ophelie43/RobotRehab2D/CAD/Assemblage RobotRehab Final.SLDASM

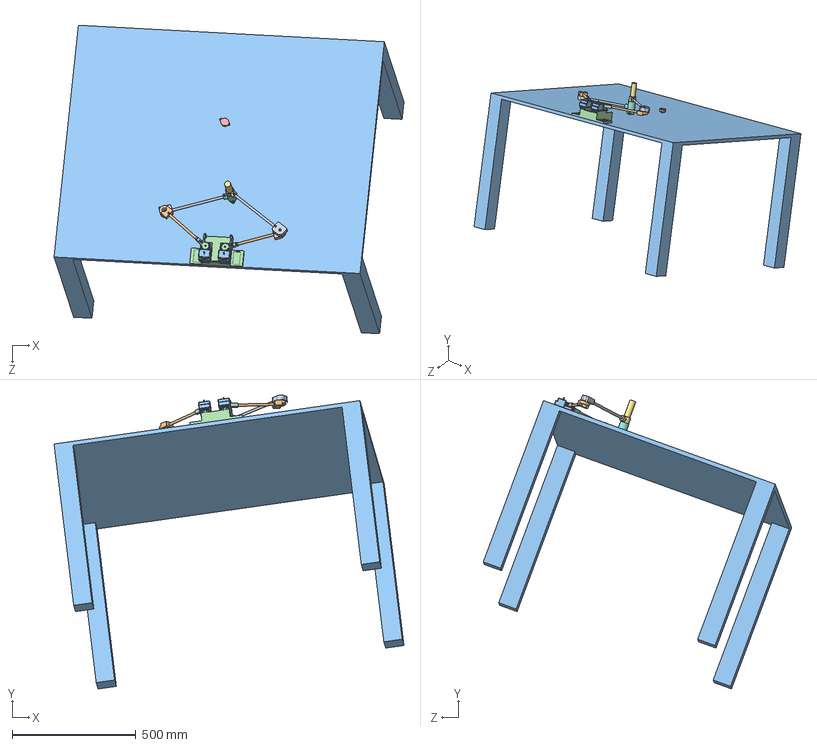
[picture p11: CAD file, 2026-05-04]
CAD/Assemblage RobotRehab Final.SLDASM
1413.6 x 1186.9 x 1246.0 mm
Servomotor x 2
Servo holder x 2
Bearing x 3
Caster ball
Base
Desk
joint_intermediaire_dessous_vis x 2
joint_intermediare_dessus_vis x 2
Joint_end_effector_nouveau_bearing
Joint_poignee_nouveau_bearing
Couvert servo x 2
Engrenage 1 x 2
engrenage-sero x 2
Couver engrenage x 2
Bar R1 x 2
Bar R2-L x 2
