ophelie43/RobotRehab2D/CAD/Caster ball.SLDPRT

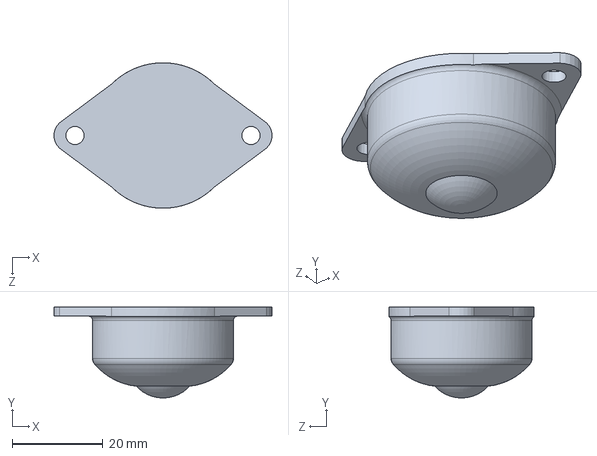
[picture p12: CAD file, 2026-05-04]
CAD/Caster ball.SLDPRT
47.9 x 20.0 x 32.0 mm
