ophelie43/RobotRehab2D/CAD/Engrenage 1.SLDPRT

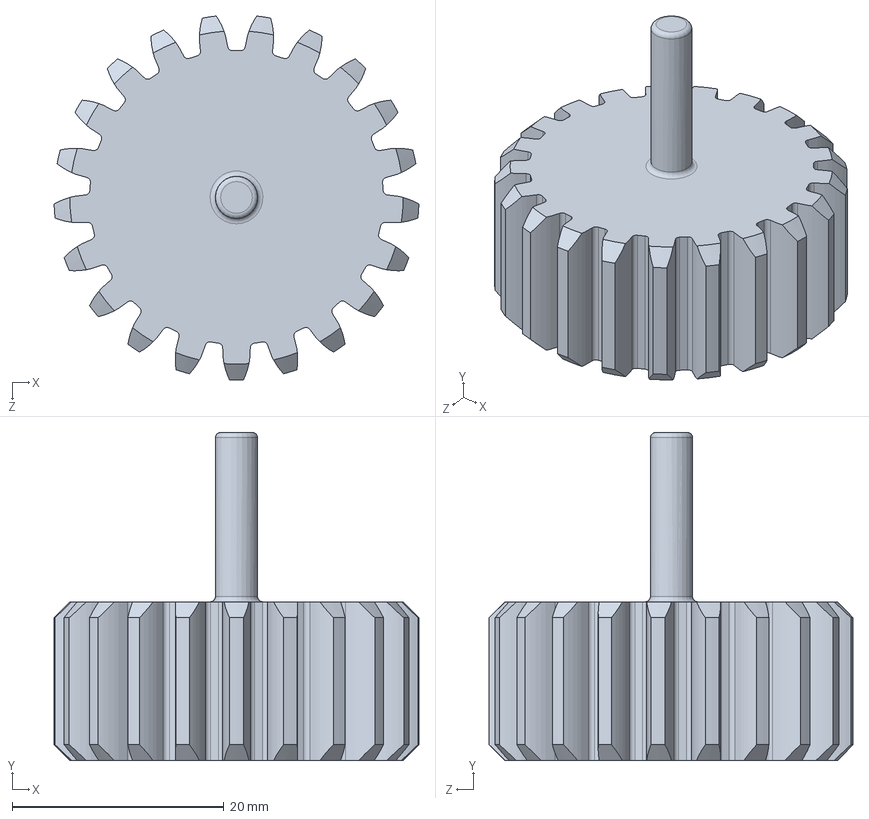
[picture p13: CAD file, 2026-05-04]
CAD/Engrenage 1.SLDPRT
34.5 x 31.0 x 34.4 mm
