ophelie43/RobotRehab2D/CAD/Joint_end_effector_nouveau_bearing.SLDPRT

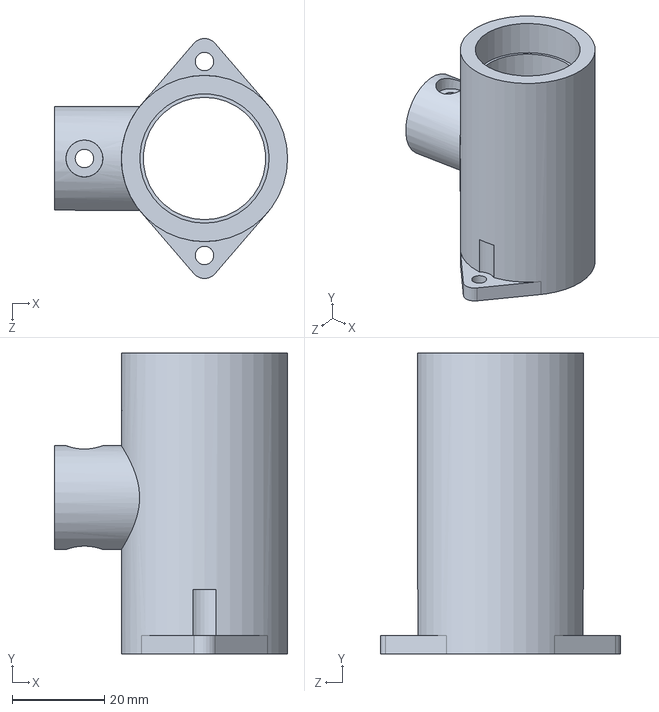
[picture p14: CAD file, 2026-05-04]
CAD/Joint_end_effector_nouveau_bearing.SLDPRT
50.5 x 65.2 x 52.0 mm
