ophelie43/RobotRehab2D/CAD/Couvert servo.SLDPRT

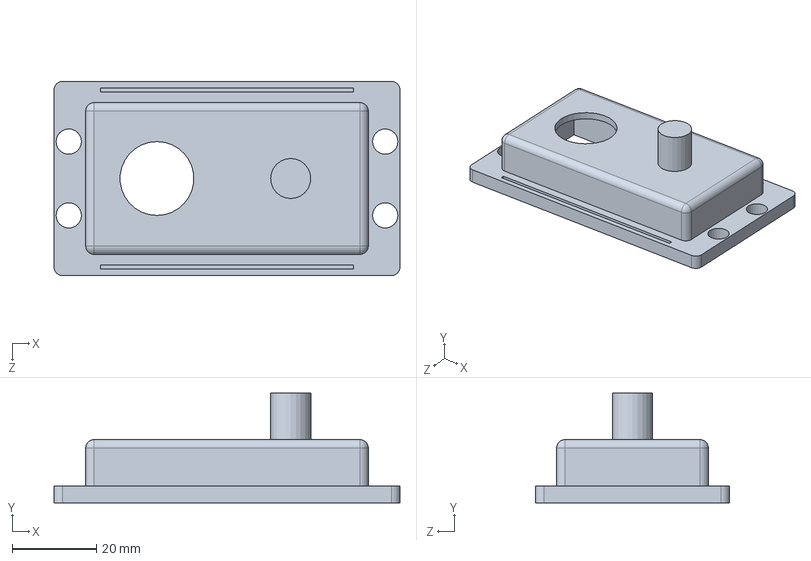
[picture p15: CAD file, 2026-05-04]
CAD/Couvert servo.SLDPRT
82.0 x 26.0 x 46.0 mm
