ophelie43/RobotRehab2D/CAD/Joint_poignee_nouveau_bearing.SLDPRT

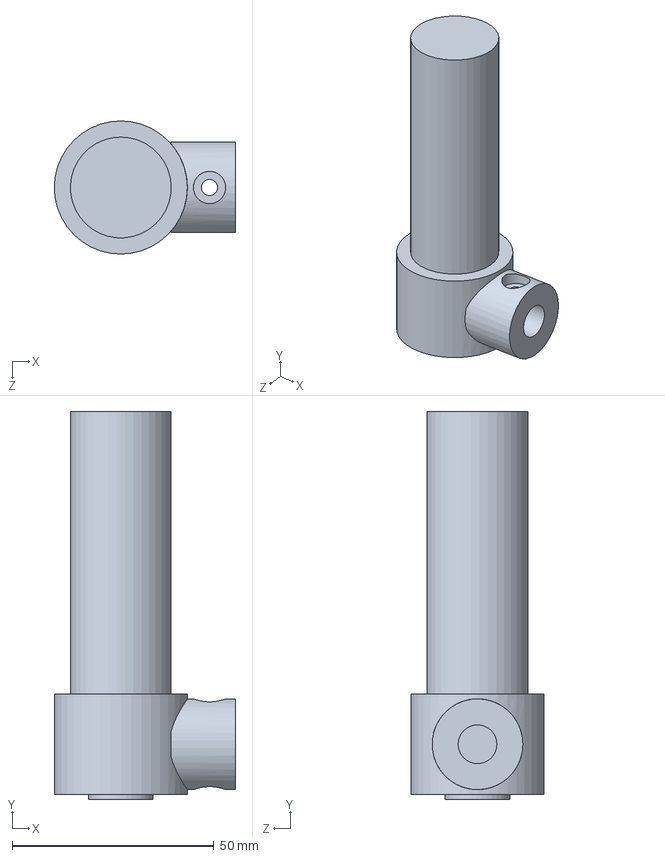
[picture p16: CAD file, 2026-05-04]
CAD/Joint_poignee_nouveau_bearing.SLDPRT
45.0 x 96.2 x 33.0 mm
