ophelie43/RobotRehab2D/CAD/Base.SLDPRT

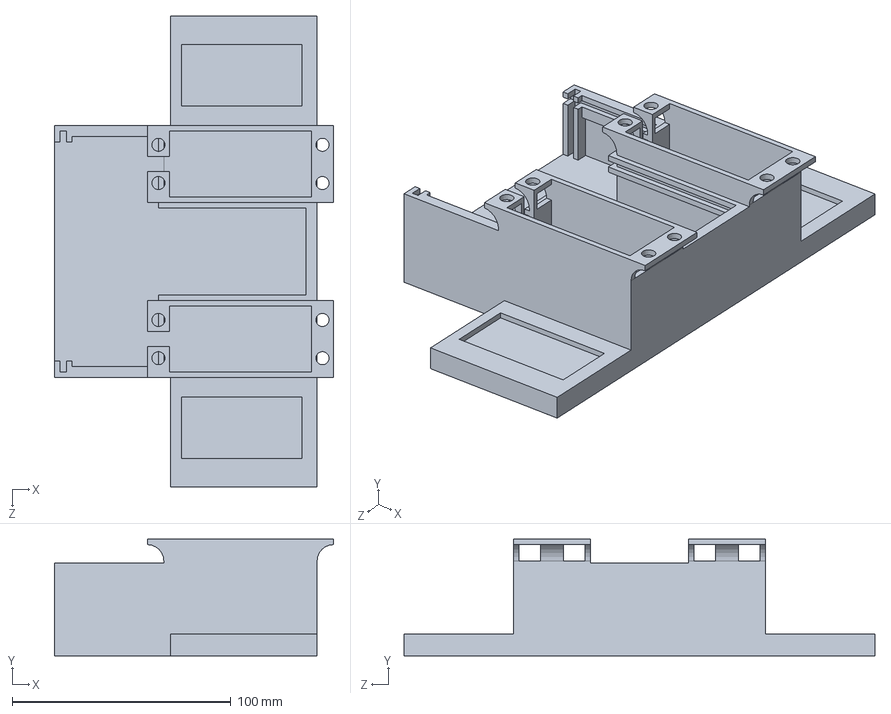
[picture p17: CAD file, 2026-05-04]
CAD/Base.SLDPRT
127.6 x 53.4 x 215.2 mm
