ophelie43/RobotRehab2D/CAD/engrenage-sero.SLDPRT

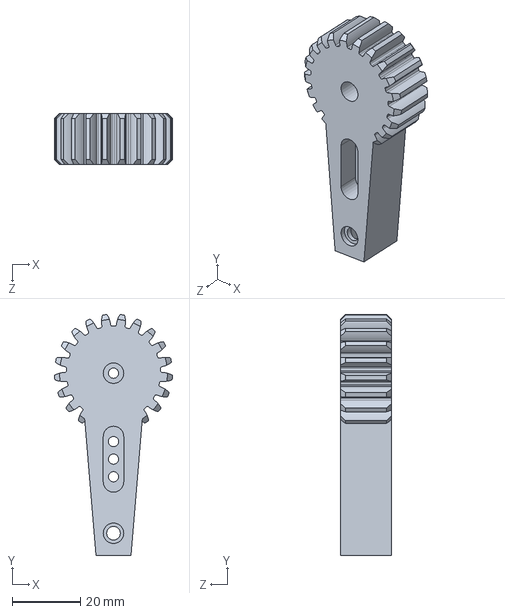
[picture p18: CAD file, 2026-05-04]
CAD/engrenage-sero.SLDPRT
34.5 x 70.4 x 15.0 mm
