ophelie43/RobotRehab2D/CAD/joint_intermediaire_dessous_vis.SLDPRT

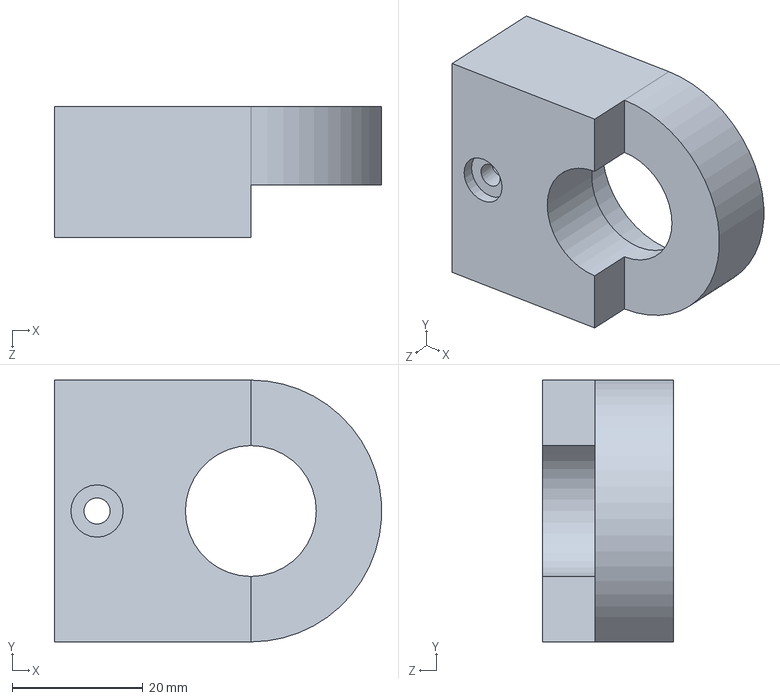
[picture p19: CAD file, 2026-05-04]
CAD/joint_intermediaire_dessous_vis.SLDPRT
50.0 x 40.0 x 20.0 mm
