ophelie43/RobotRehab2D/CAD/Servo holder.SLDPRT

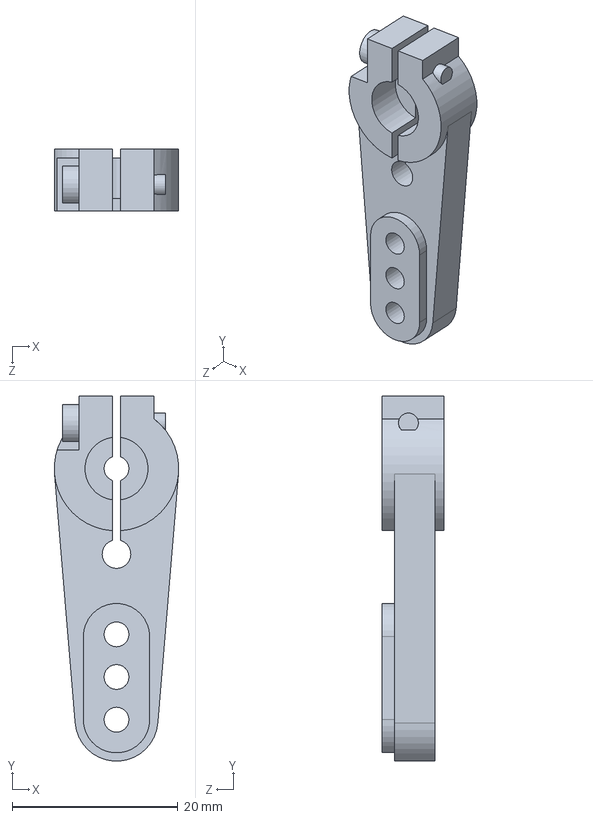
[picture p20: CAD file, 2026-05-04]
CAD/Servo holder.SLDPRT
15.0 x 44.0 x 7.47 mm
