ophelie43/RobotRehab2D/CAD/Bar R1.SLDPRT

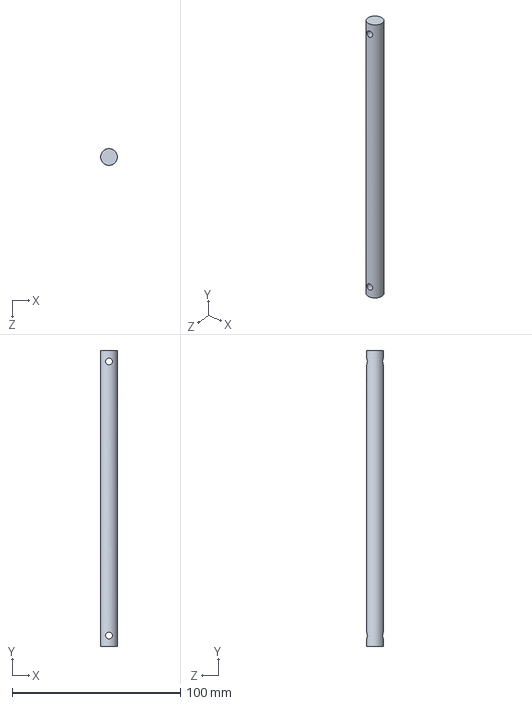
[picture p21: CAD file, 2026-05-04]
CAD/Bar R1.SLDPRT
9.95 x 176.0 x 10.0 mm
