ophelie43/RobotRehab2D/CAD/Bar R2-L.SLDPRT

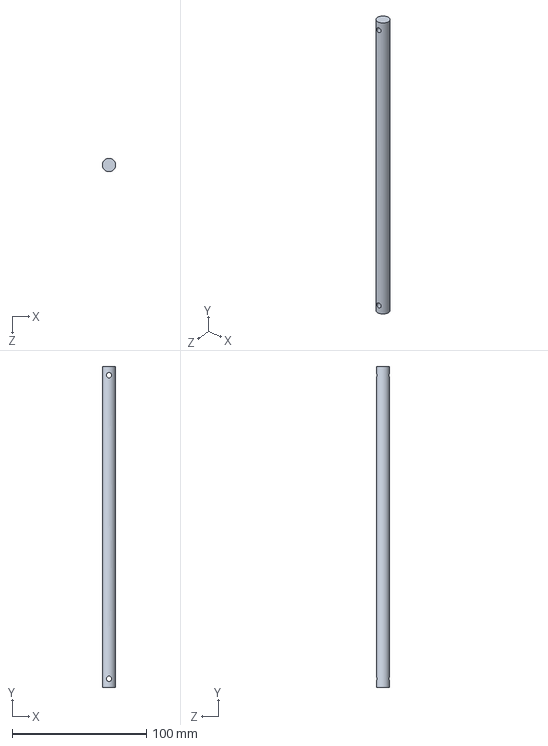
[picture p22: CAD file, 2026-05-04]
CAD/Bar R2-L.SLDPRT
10.0 x 239.5 x 10.0 mm
