ophelie43/RobotRehab2D/CAD/joint_intermediare_dessus_vis.SLDPRT

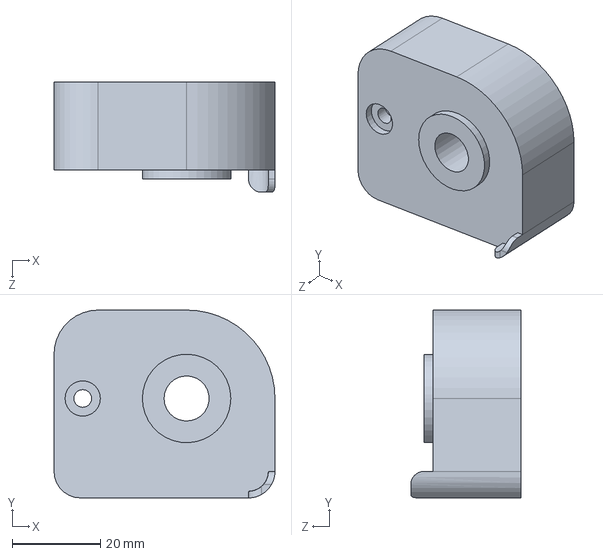
[picture p23: CAD file, 2026-05-04]
CAD/joint_intermediare_dessus_vis.SLDPRT
50.0 x 42.5 x 25.0 mm
