ophelie43/RobotRehab2D/CAD/Bearing.SLDPRT

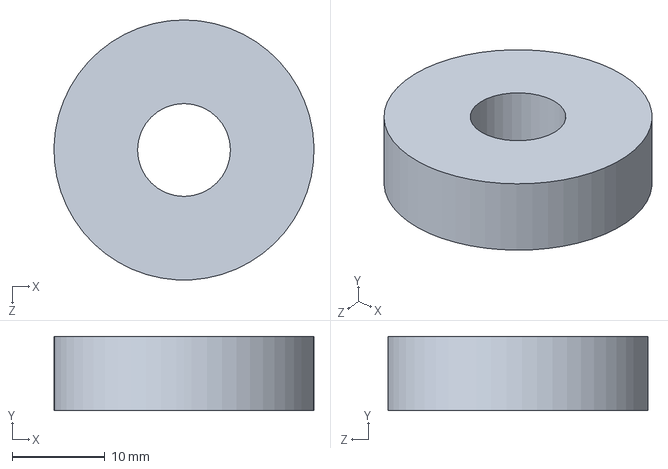
[picture p24: CAD file, 2026-05-04]
CAD/Bearing.SLDPRT
28.0 x 8.00 x 28.0 mm
