ophelie43/RobotRehab2D/CAD/Desk.SLDPRT

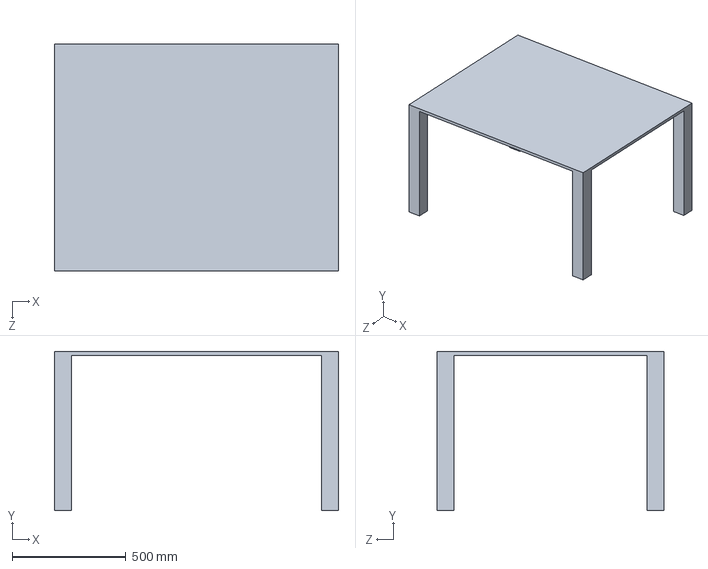
[picture p25: CAD file, 2026-05-04]
CAD/Desk.SLDPRT
1250.0 x 700.0 x 1000.0 mm
