ophelie43/RobotRehab2D/CAD/Couver engrenage.SLDPRT

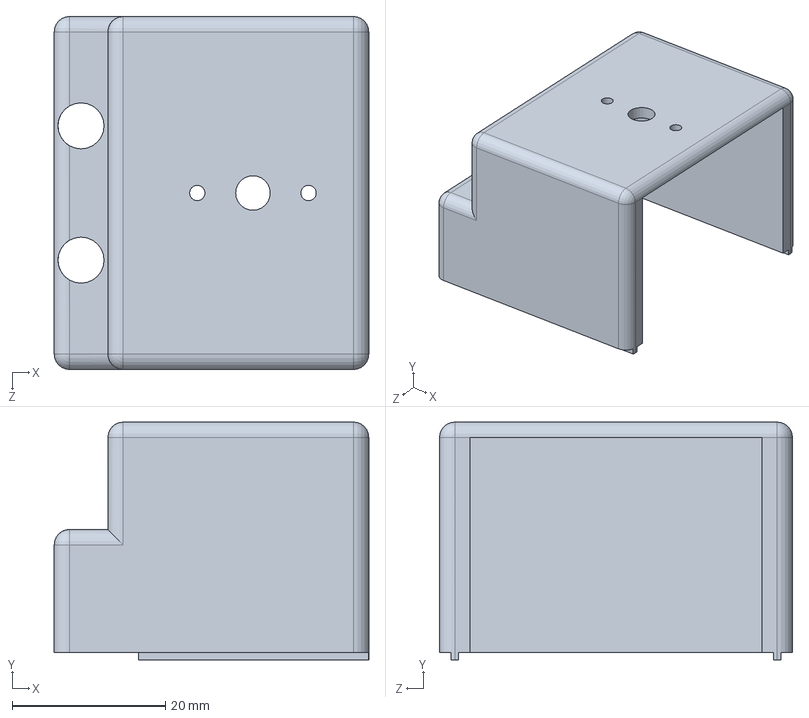
[picture p26: CAD file, 2026-05-04]
CAD/Couver engrenage.SLDPRT
41.0 x 31.0 x 46.0 mm
