ophelie43/RobotRehab2D/CAD/Servomotor.SLDPRT

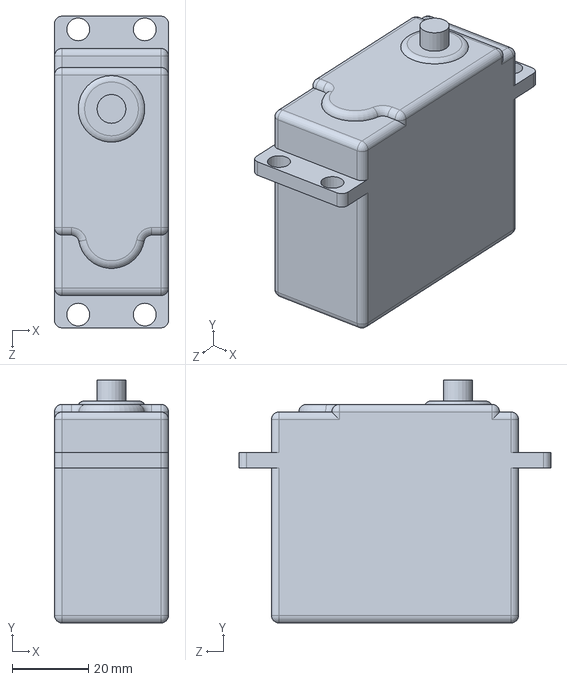
[picture p27: CAD file, 2026-05-04]
CAD/Servomotor.SLDPRT
30.0 x 63.9 x 82.0 mm
