ophelie43/RobotRehab2D/CAD/3531_0.SLDASM

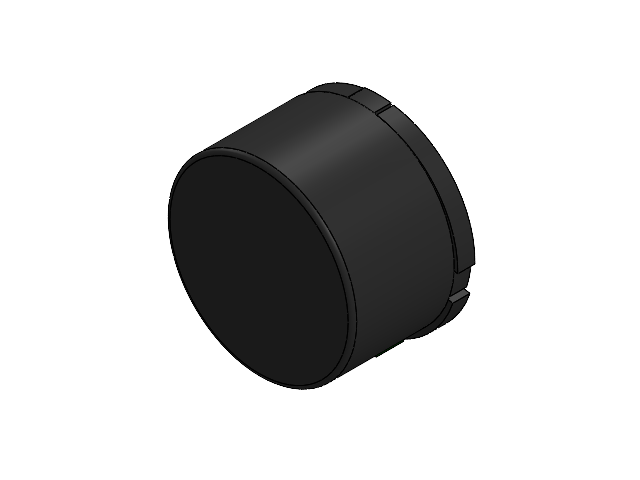
[picture p28: CAD file, 2026-05-04]
CAD/3531_0.SLDASM
ID_1.stp
ID_1-0.stp
ID_1-1.stp
ID_1-2.stp
