ophelie43/RobotRehab2D/Controle/Test_csv_cercles.xlsx

Sheet: 10cercles_sans_barres_PID
Horodatage | Essai_ID | X_Voulu | Y_Voulu | Theta1_Cible | Theta4_Cible | Correction_M1 | Correction_M2 | X_Encodeur | Y_Encodeur | Theta1_Encodeur | Theta4_Encodeur | Courant1 | Courant4 | Tau1 | Tau4 | Force1 | Force4 | Jacobien
2026-04-19 14:35 | 1 | 0.1 | 0.35 | 131.36 | 27.4 | -0.1 | -12.05 | 0.0881 | 0.3702 | 131.4 | 32.4 | 0.01 | 0.05 | 0.103 | 0.084 | 0.167 | 0.032 | 4.5706
2026-04-19 14:35 | 2 | 0.09995065604 | 0.3531410759 | 131.05 | 27.91 | -0.53 | -2.79 | 0.0881 | 0.3702 | 131.4 | 32.4 | 0.01 | 0.16 | 0.104 | 0.03 | 0.158 | 0.023 | 4.5706
2026-04-19 14:35 | 3 | 0.09980267284 | 0.356279052 | 130.75 | 28.43 | -0.81 | -3.67 | 0.0896 | 0.3678 | 131.4 | 31.8 | 0.01 | 0.35 | 0.102 | 0.066 | 0.101 | 0.01 | 18.8206
2026-04-19 14:35 | 4 | 0.09955619646 | 0.3594108313 | 130.47 | 28.97 | -0.22 | -1.08 | 0.096 | 0.3625 | 130.8 | 30 | 0.02 | 0.02 | 0.1 | 0.097 | 0.048 | -0.157 | 0.4411
2026-04-19 14:35 | 5 | 0.09921147013 | 0.3625333234 | 130.2 | 29.52 | -0.04 | -1.3 | 0.0995 | 0.3621 | 130.2 | 29.4 | 0.01 | 0.02 | 0.103 | 0.097 | -0.728 | 2.329 | -0.0636
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
