ophelie43/RobotRehab2D/(commit log)

2026-01-12 Code servo été 2025
2026-03-16 Create Controle_position_lecture_encodeur
    Code qui calibre les encodeurs, envoie des positions cartésiennes, et lit les encodeurs
2026-03-16 Create Generer_trajectoire
    Genere trajectoire mais pas de fichiers csv encore
2026-04-04 Create PID
2026-04-07 ajout lecture courant
    [CERCLE.csv, Carre.csv, suivi_robot.csv]
2026-04-16 Correction lecture de courant; ça lit le courant maintenant
    [PID.py, main.py]
2026-04-16 Ajout de la conversion du courant en torque et calcul de la force avec modélisation dynamique
    [rectangle.csv]
2026-04-19 Create Analyse_force.py
    Code qui fait les graphes de vecteurs de force
2026-04-30 Ménage des scripts en double et ajout d'un script pour modifier les cvs de données de position, courant et angle.
    [10_rectangle_essai2.csv, 10_rectangle_essai2_MODIFIÉ.csv, 10carres_barre.csv, 10cercles_barre.csv, 10cercles_barre_MODIFIÉ.csv, 10cercles_sans_barres_PID.csv, 10cercles_sans_barres_PID_MODIFIÉ.csv, 10cercles_sans_barres_sans_PID.csv]
2026-05-01 Ajout du contrôle par admittance dans PID2.py
    [10_rectangle_essai2_MODIFIÉ.csv, 10cercles_barre_MODIFIÉ.csv, rectangle.csv]
2026-05-04 Add files via upload
    Ajout des fichiers CAD
    [3531_0.SLDASM, Assemblage RobotRehab Final.SLDASM, Bar R1.SLDPRT, Bar R2-L.SLDPRT, Base.SLDPRT, Bearing.SLDPRT, Caster ball.SLDPRT, Couver engrenage.SLDPRT]
2026-05-04 Ajout du dossier nom_du_dossier
    [10_rectangle_essai2_MODIFIÉ.csv, 3531_0.SLDASM, Assemblage RobotRehab Final.SLDASM, Bar R1.SLDPRT, Bar R2-L.SLDPRT, Base.SLDPRT, Bearing.SLDPRT, Caster ball.SLDPRT]
2026-05-04 Suppression de 3531_0.SLDASM
    [3531_0.SLDASM]
2026-05-04 Supression de fichiers en double
    [Bar R1.SLDPRT, Bar R2-L.SLDPRT, Base.SLDPRT, Bearing.SLDPRT, Caster ball.SLDPRT]
2026-05-04 Suppression de fichiers en double
    [Assemblage RobotRehab Final.SLDASM, Couver engrenage.SLDPRT, Couvert servo.SLDPRT, Desk.SLDPRT, Engrenage 1.SLDPRT, Joint_end_effector_nouveau_bearing.SLDPRT, Joint_poignee_nouveau_bearing.SLDPRT, Servo holder.SLDPRT]
2026-05-04 Ajout de commentaires PID2.py, admittance_control()
2026-05-04 Ajustement code admittance; diminution du damping et correction direction de l'angle du moteur
2026-05-05 Réorganisation des dossiers
    [10_rectangle_essai2.csv, 10_rectangle_essai2_MODIFIÉ.csv, 10carres_barre.csv, 10cercles_barre.csv, 10cercles_barre_MODIFIÉ.csv, 10cercles_sans_barres_PID.csv, 10cercles_sans_barres_PID_MODIFIÉ.csv, 10cercles_sans_barres_sans_PID.csv]
